WirelessThings/OpenPi/readme.rst

====================
OpenPi by Ciseco Ltd
====================

OpenPi by Ciseco Ltd is licensed under a Creative Commons Attribution-ShareAlike 4.0 International License.
