WirelessThings/OpenPi/Eagle/Compute v0.5 Schematic.pdf

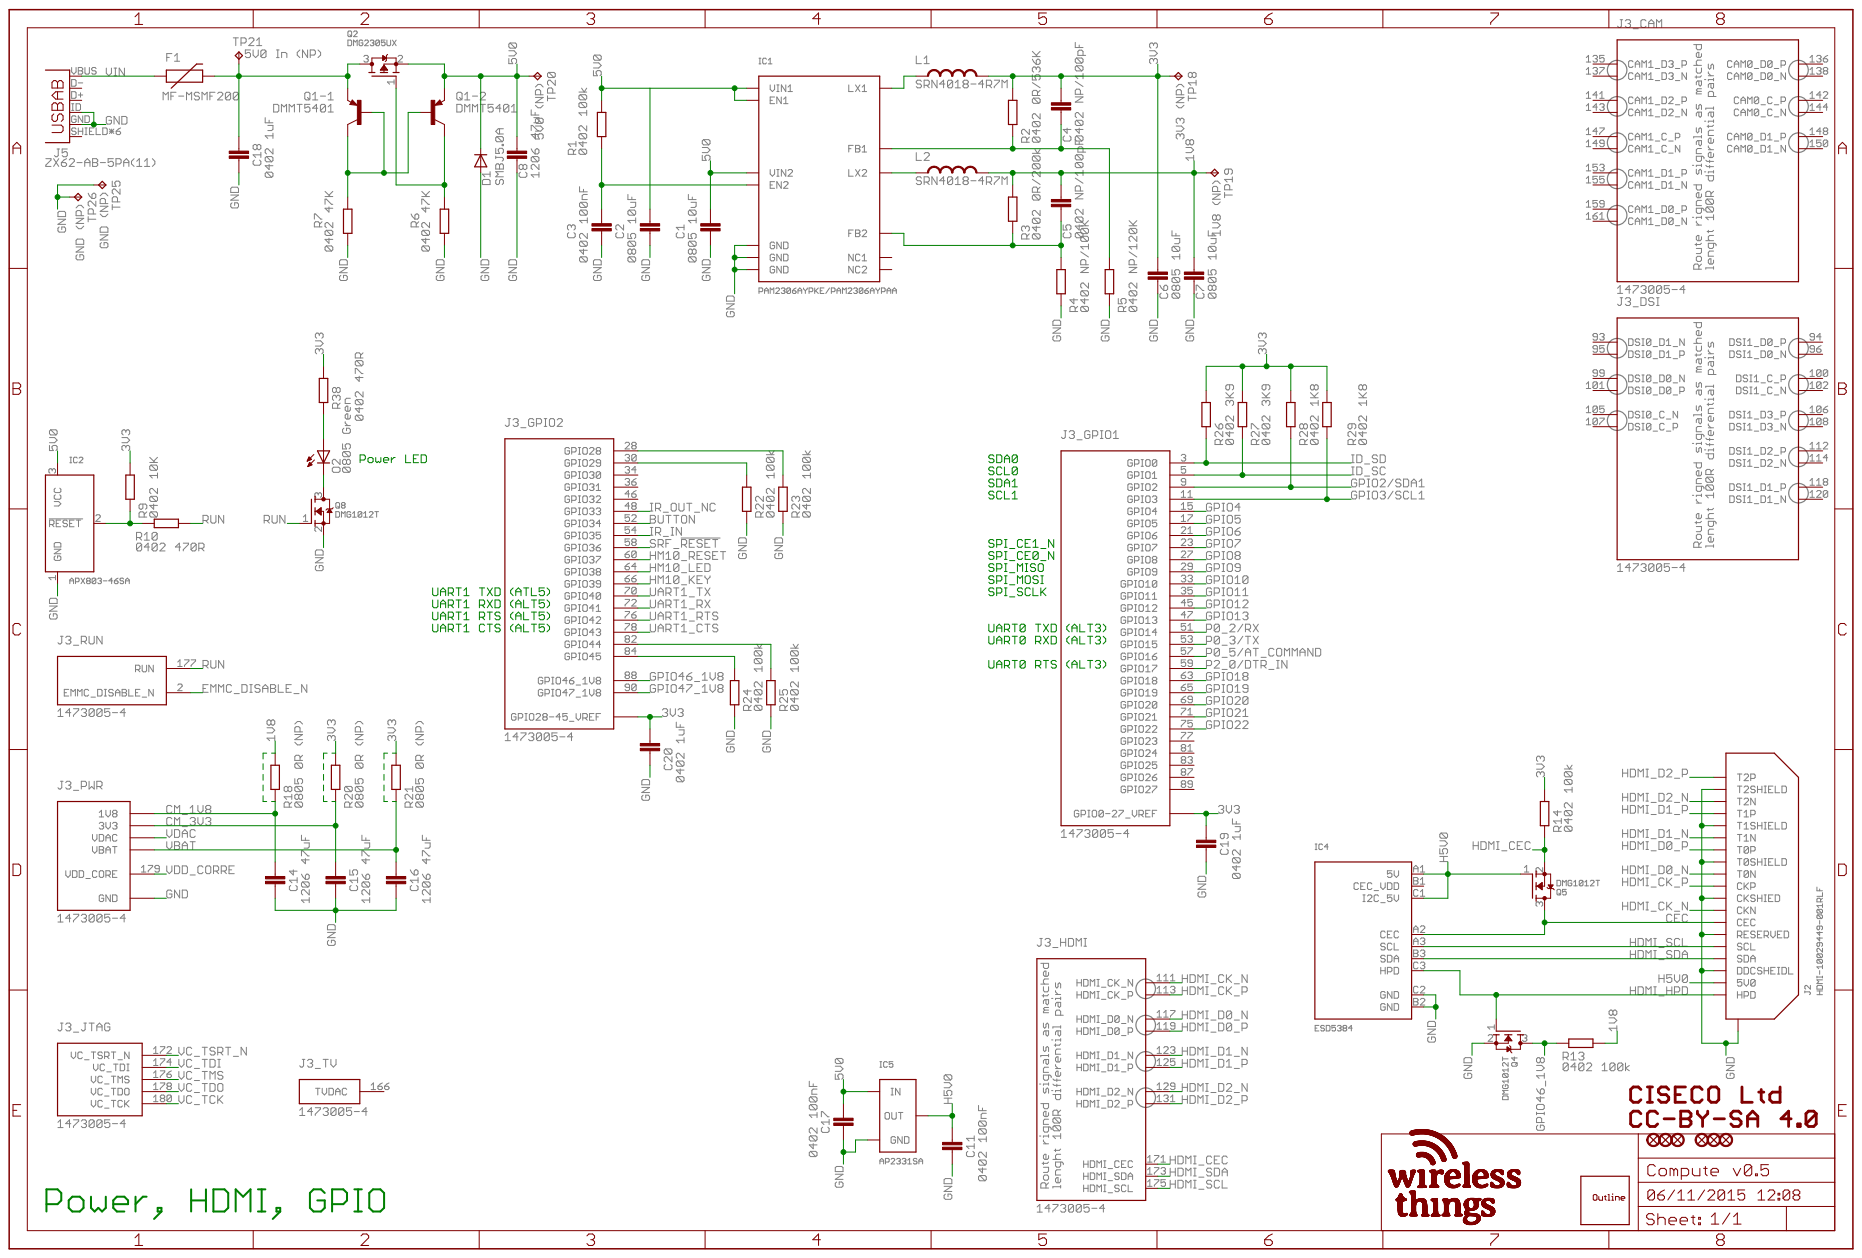
[picture p1: page 1]

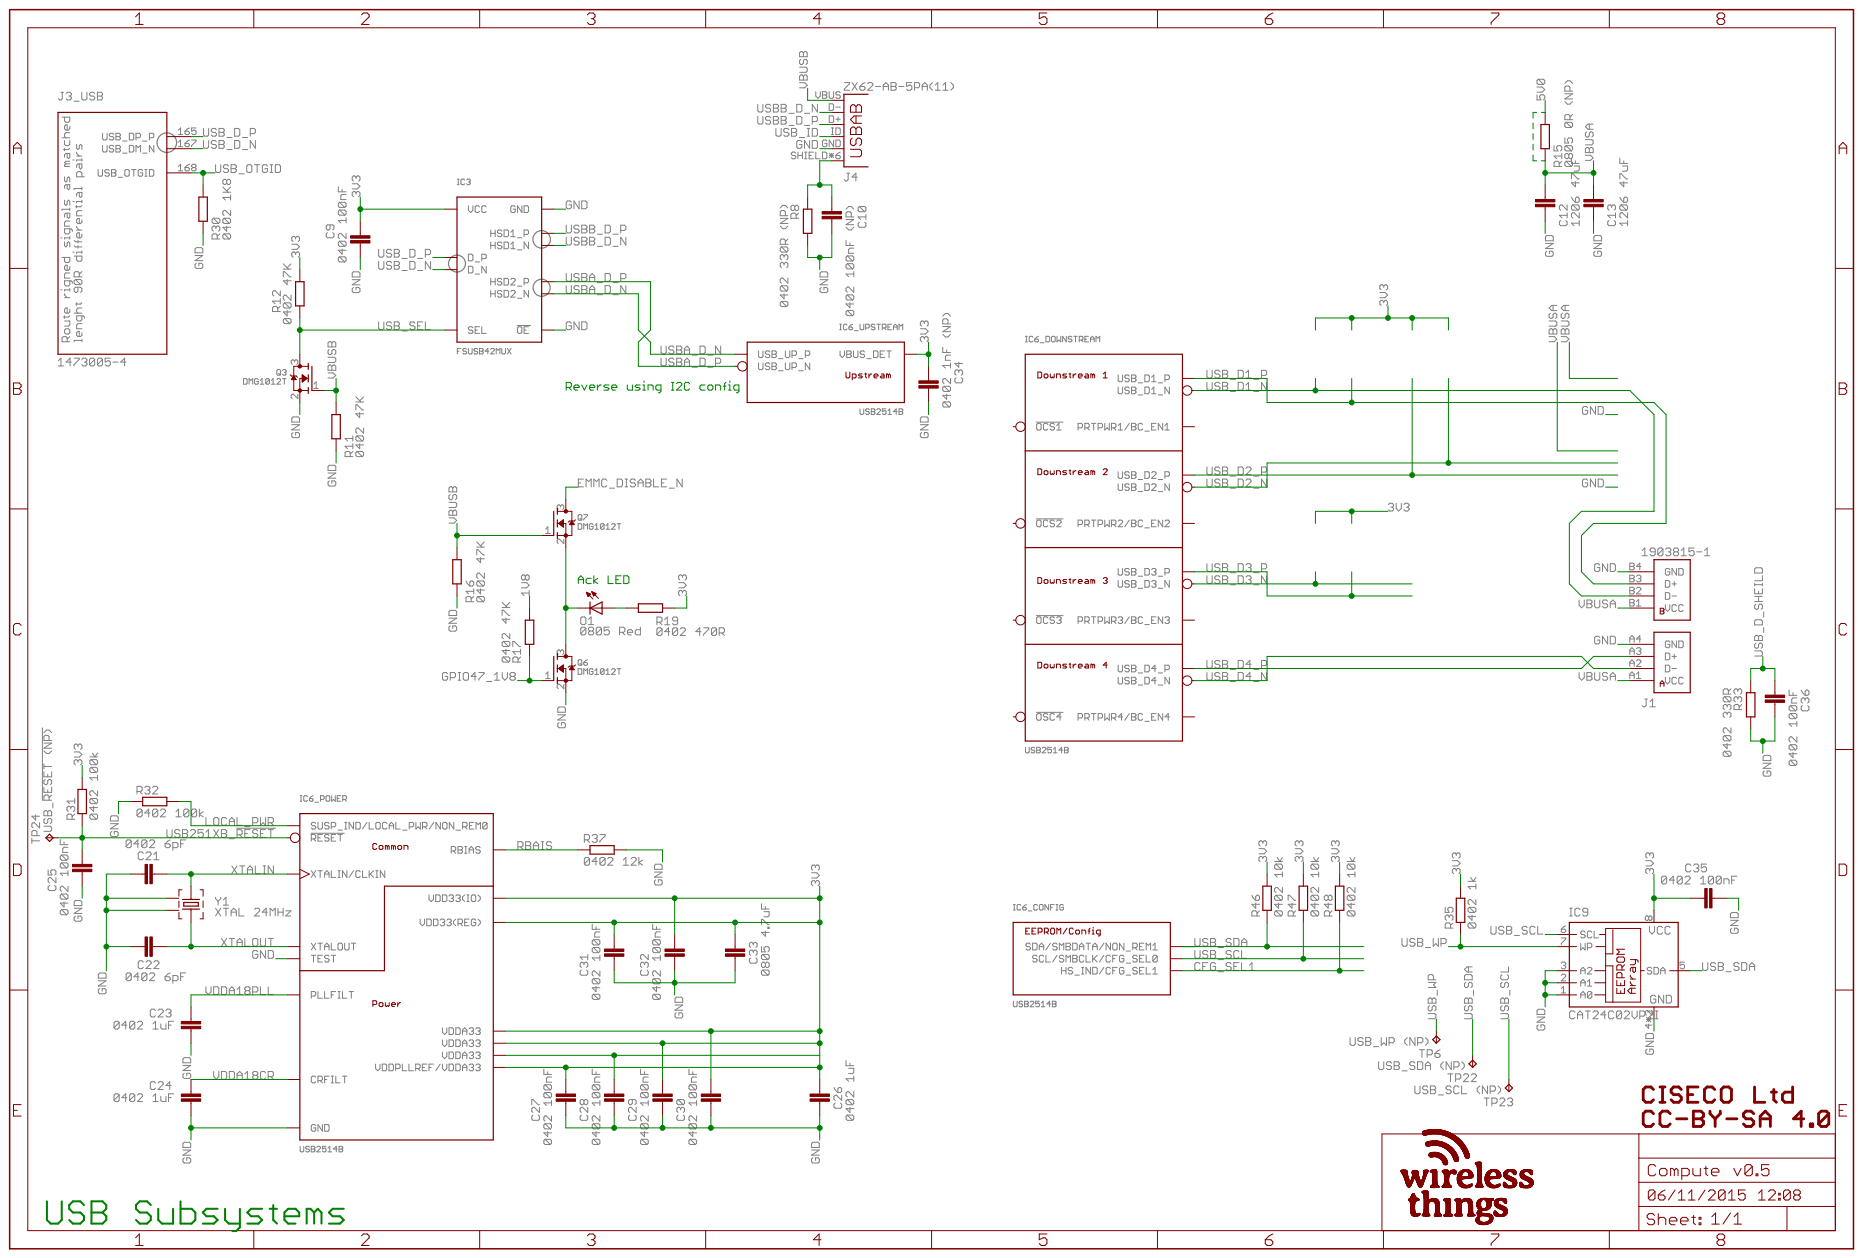
[picture p2: page 2]

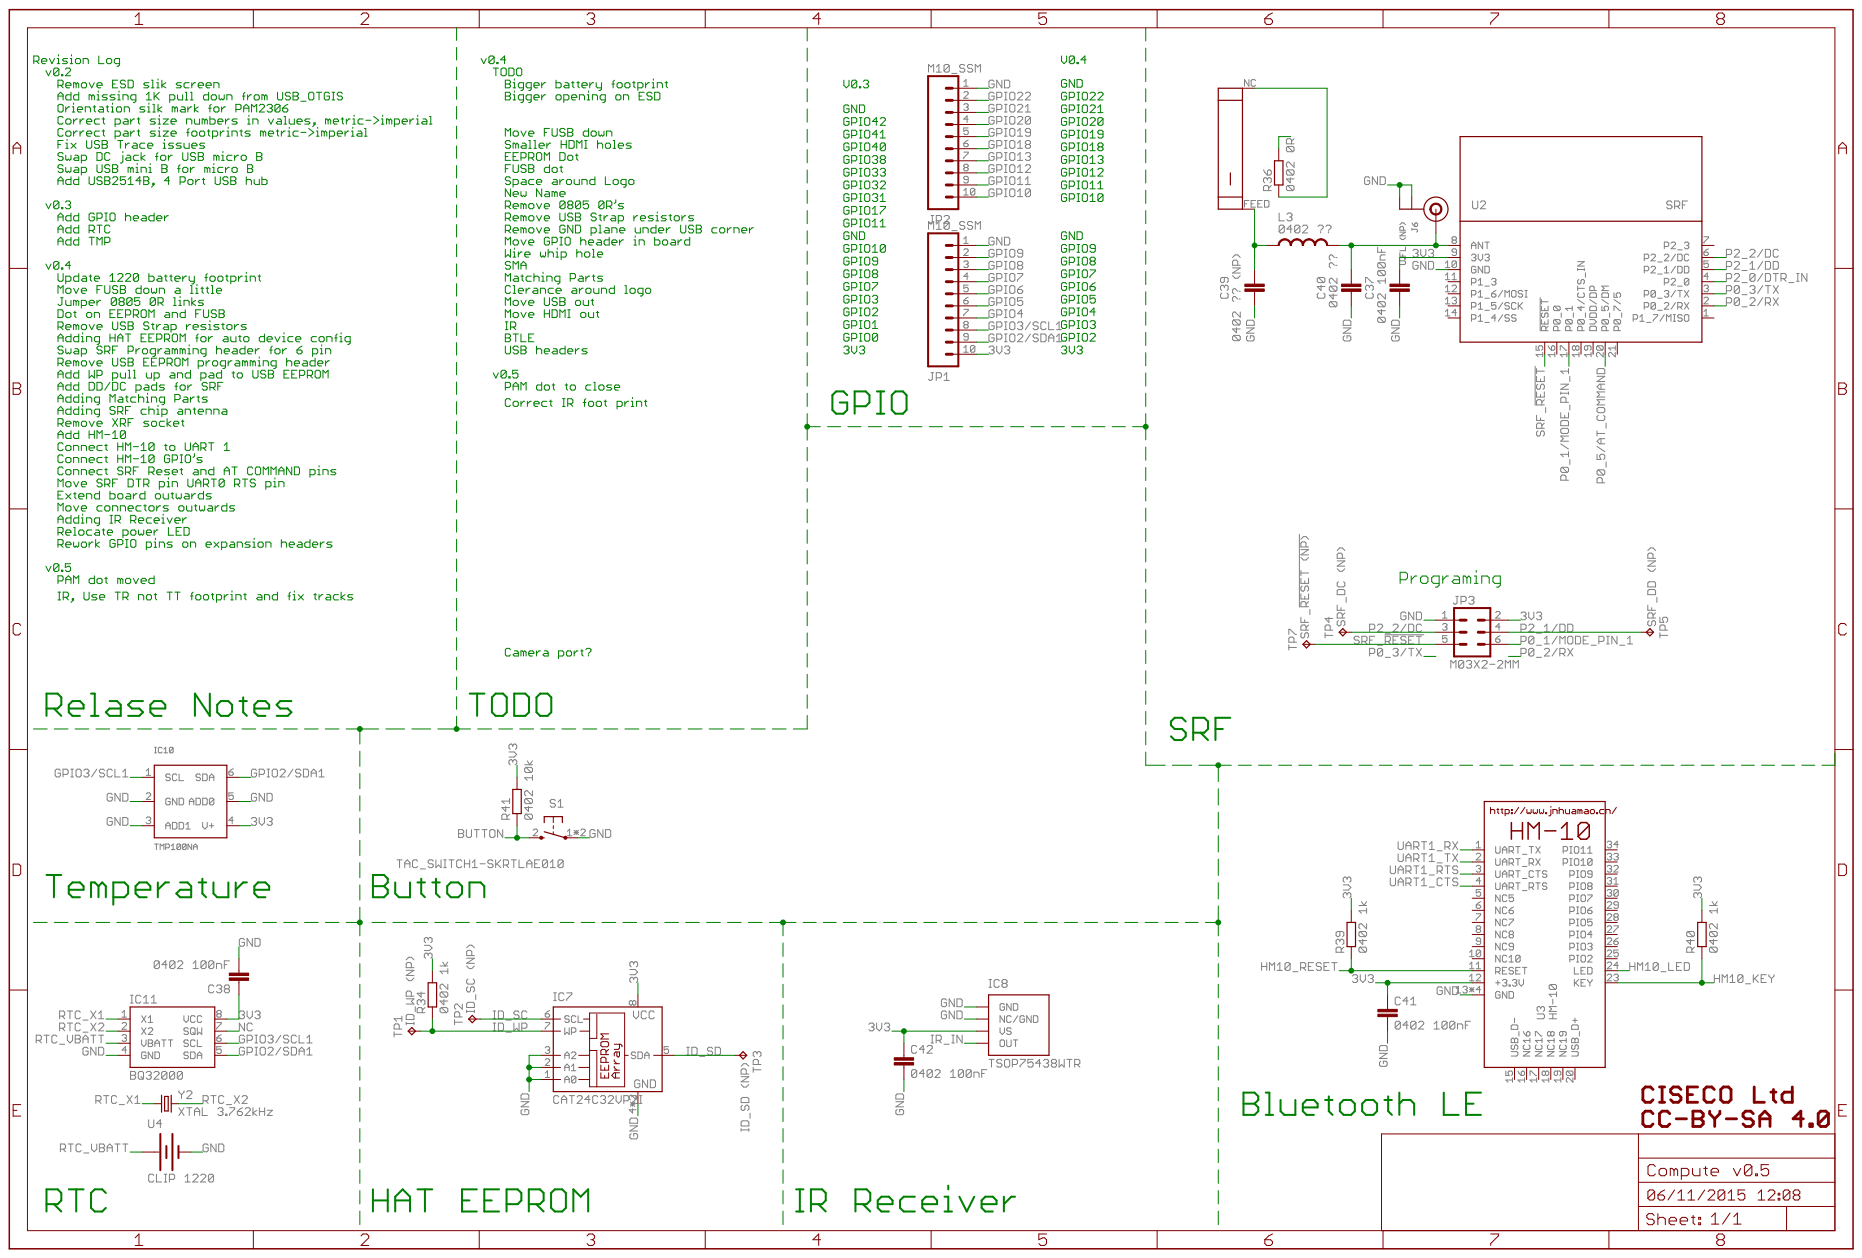
[picture p3: page 3]
