WirelessThings/OpenPi/Eagle/Compute v0.5 Bottom.pdf

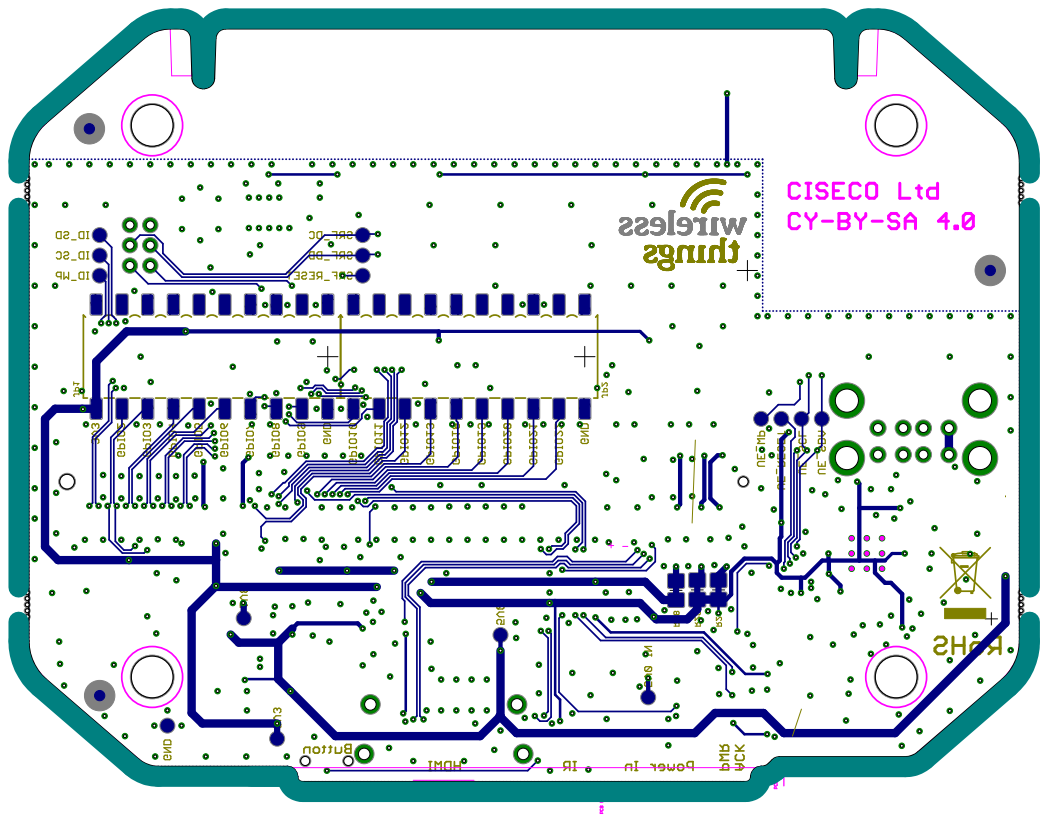
[picture p4: page 1]
