WirelessThings/OpenPi/Eagle/Compute v0.5 Top.pdf

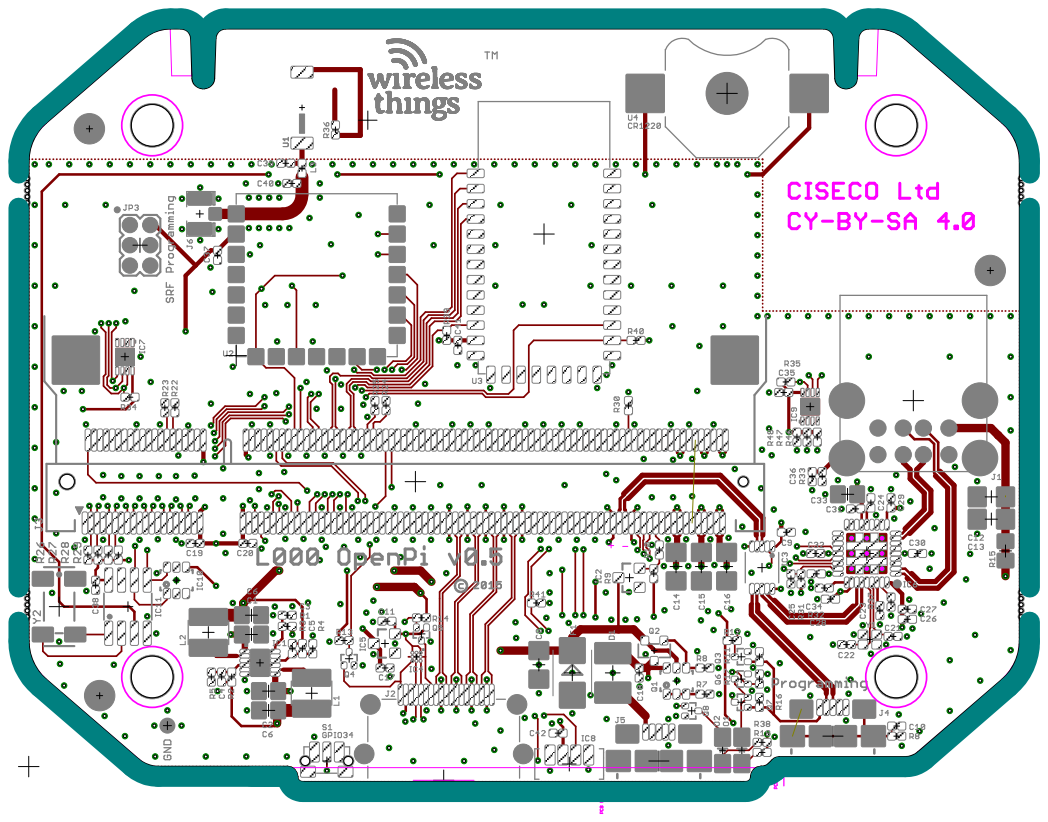
[picture p5: page 1]
